phutruonnttn/braille-setup/pcb-audit/video-storyboard-2.jpg

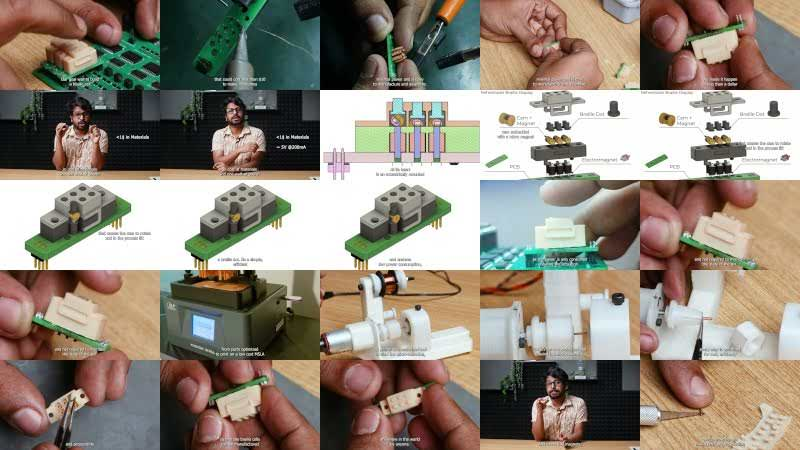
pcb-audit/video-storyboard-2.jpg
