phutruonnttn/braille-setup/pcb-audit/video-storyboard-3.jpg

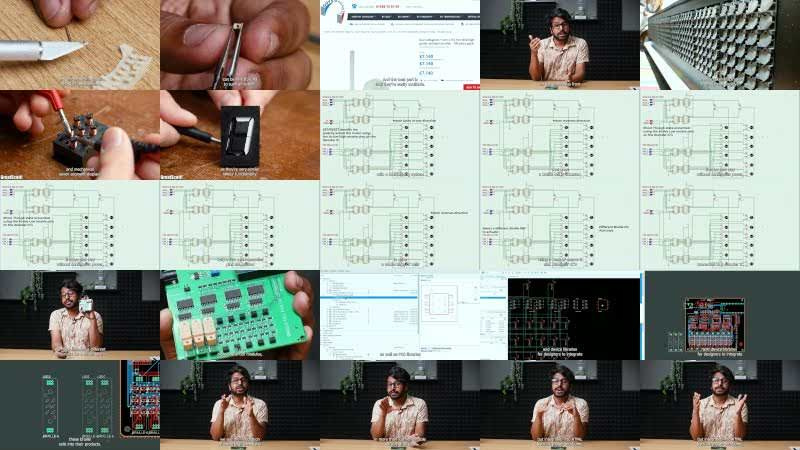
pcb-audit/video-storyboard-3.jpg
