phutruonnttn/braille-setup/pcb-order-4cells-1/verification/cell-drill-report.txt

Drill report for Braille-Cell.kicad_pcb
Created on 2026-10-12T14:58:37

Copper Layer Stackup:
    =============================================================
    L1 :  F.Cu                      front
    L2 :  B.Cu                      back

Drill file 'Braille-Cell-PTH.drl' contains
    plated through holes:
    =============================================================
    T1  0.350mm  0.0138"  (3 holes))
    T2  0.350mm  0.0138"  (12 holes))
    T3  0.600mm  0.0236"  (12 holes))

    Total plated holes count 27

Drill file 'Braille-Cell-NPTH.drl' contains
    unplated through holes:
    =============================================================
    T1  1.100mm  0.0433"  (6 holes))
    T2  1.600mm  0.0630"  (2 holes))
    T3  2.100mm  0.0827"  (2 holes))

    Total unplated holes count 10
