phutruonnttn/braille-setup/guide/overview-preview.png

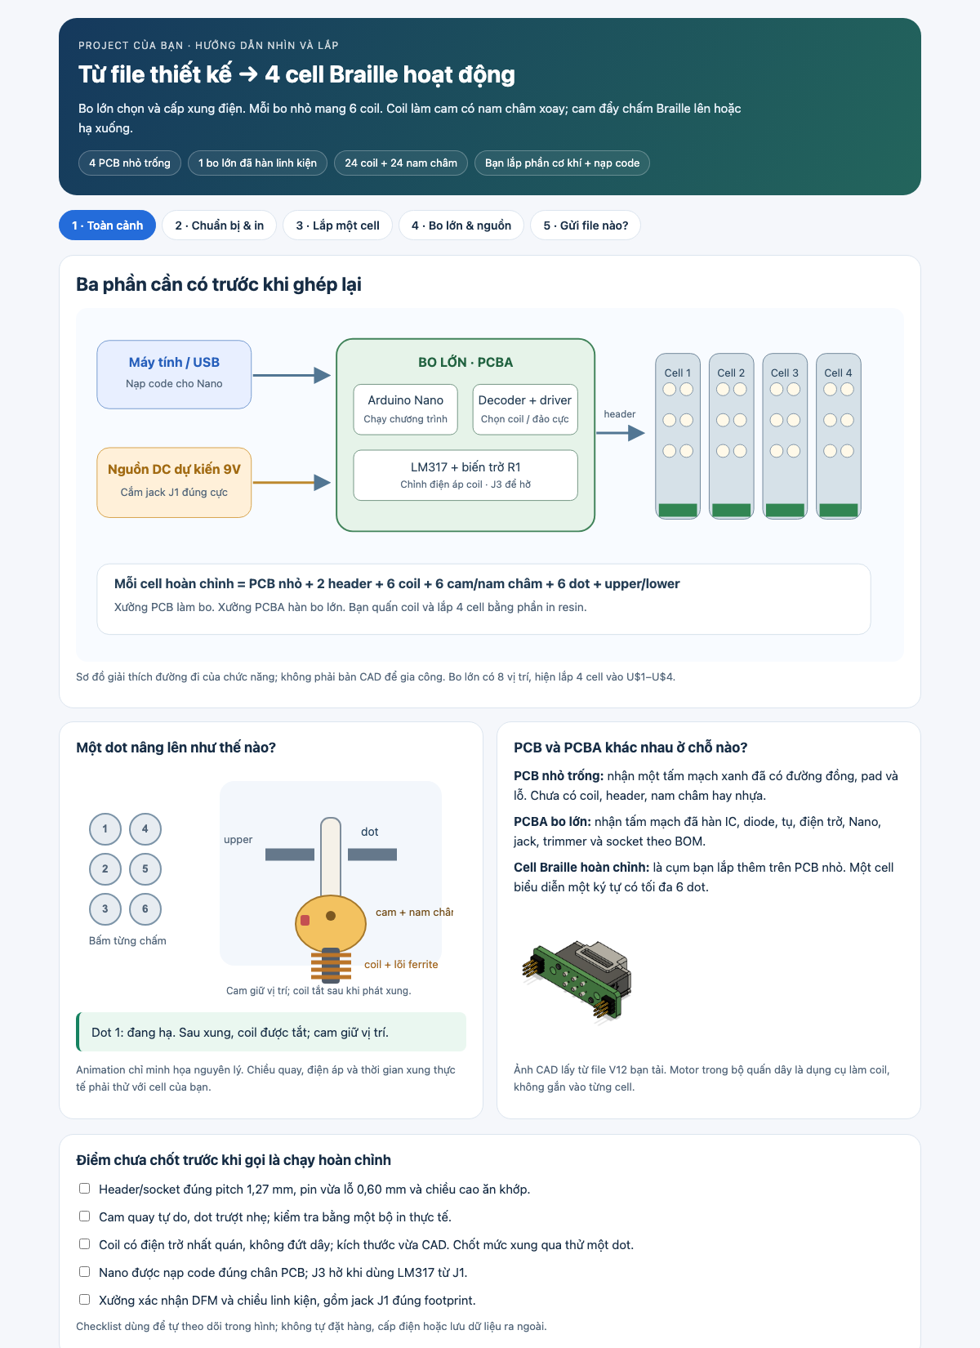
guide/overview-preview.png
