phutruonnttn/braille-setup/pcb-audit/video-storyboard-0.jpg

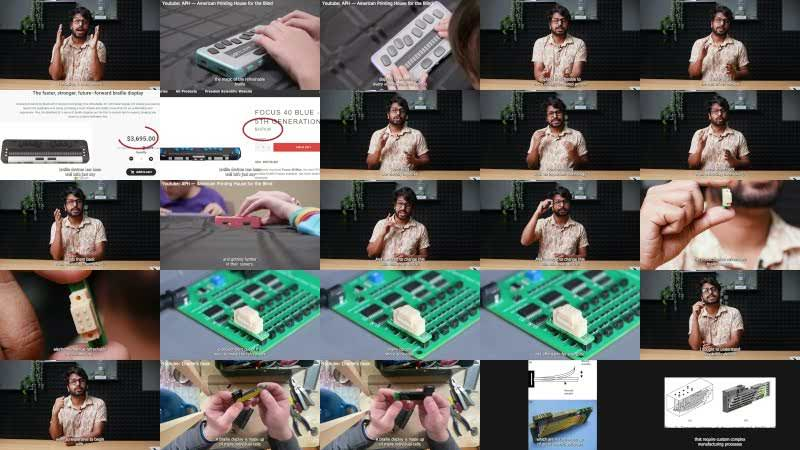
pcb-audit/video-storyboard-0.jpg
