phutruonnttn/braille-setup/pcb-audit/video-storyboard-1.jpg

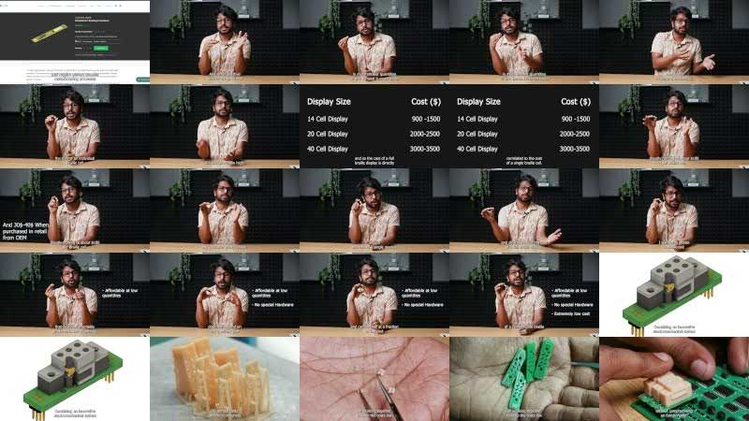
pcb-audit/video-storyboard-1.jpg
