phutruonnttn/braille-setup/pcb-audit/video-storyboard-4.jpg

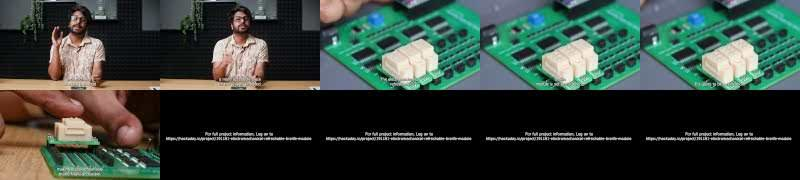
pcb-audit/video-storyboard-4.jpg
