phutruonnttn/braille-setup/pcb-audit/vn-update-2026-10-13/previews/cell-vn-bottom.png

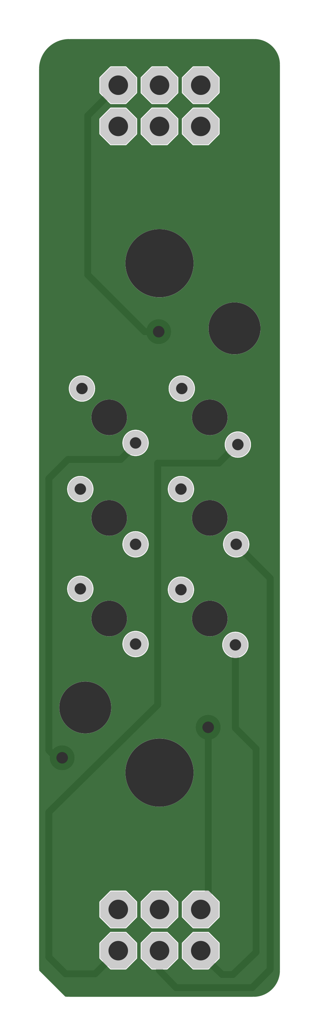
pcb-audit/vn-update-2026-10-13/previews/cell-vn-bottom.png
