phutruonnttn/braille-setup/guide/ferrite-sourcing-Singapore-2026-10-12.md

# Nguồn lõi ferrite cho 4 ô Braille tại Singapore

Kiểm tra ngày 12/10/2026. Giá/tồn kho trên web có thể thay đổi; trợ lý chưa gửi liên hệ hay đặt hàng.

**Cập nhật sau email bạn nhận:** Fair-Rite Asia xác nhận không có hàng để tự lấy tại Singapore; MOQ/SOQ thông thường 6.000 chiếc, đơn nhỏ tùy hàng có sẵn ở Mỹ; vận chuyển Ex-Factory, đề nghị khách tự thu xếp courier. Mục “Ưu tiên 1” dưới đây là phương án hỏi trước khi có phản hồi, hiện đã có kết quả không đáp ứng yêu cầu mua sẵn tại Singapore. Xem [nghiên cứu lõi thay thế và ba đầu mối mới](ferrite-alternatives-2026-10-12.md) cùng [mẫu hỏi mua mẫu](ferrite-alternative-RFQ.txt).

## Cần mua gì

BOM hiện tại cần **24 lõi**, 6 lõi cho mỗi PCB nhỏ. Nên có thêm lõi dự phòng vì dễ gãy khi quấn dây. Mã gốc **Fair-Rite 3067990831**, thanh đặc không phủ, Ø1 ±0,025 mm, dài 10 ±0,30 mm, vật liệu NiZn 67, µi điển hình 40. [Thông số hãng](https://fair-rite.com/product/antennarfid-rods-3067990831/).

## Ưu tiên 1: hỏi chính Fair-Rite tại Singapore

**Fair-Rite Asia Pte Ltd**: 61 Kaki Bukit Ave 1, #03-38 Shun Li Industrial Park; **+65 6846 1998**. Địa chỉ/số điện thoại được hãng công bố trên [trang liên hệ](https://fair-rite.com/contact-us/). Email **sales@fair-rite.com.sg** được [AEIS Singapore](https://www.aeis.org.sg/mem-fair-rite.html) công bố.

Đây là văn phòng hãng, chưa xác nhận có kho bán lẻ. Gọi trước, hỏi hàng mẫu/hàng sẵn, số lượng nhỏ và tự lấy; chỉ đi khi họ xác nhận. Chưa có bằng chứng mua được trong ngày.

Tin nhắn/email có thể gửi:

> Hello, I am based in Singapore and building a personal refreshable Braille prototype. I need 30–50 pieces of Fair-Rite 3067990831, the uncoated material-67 ferrite rod, 1 mm diameter × 10 mm length. Do you have local stock or prototype samples available? Could I self-collect in Singapore or arrange local delivery? Please advise the price, minimum quantity and earliest availability. If this part is unavailable locally, could you recommend a Singapore distributor with stock? Thank you.

## Ưu tiên 2: nhờ bên lắp PCB mua chung

Vì bạn đang nhờ xưởng sourcing linh kiện Evaluation Board, đề nghị họ mua lõi chung đơn linh kiện. Đây là cách có thể giảm phí vận chuyển riêng; phải hỏi xưởng có nhận không.

> Anh báo giúp em thêm 50 lõi Fair-Rite 3067990831, Ø1 × 10 mm, vật liệu 67, không phủ. Em dùng 24 lõi cho 4 ô Braille, phần còn lại dự phòng. Nếu bên anh có đơn DigiKey/Mouser thì anh có thể mua chung và giao lõi rời cho em để em tự quấn cuộn dây được không? Nhờ báo tổng chi phí và thời gian nhận giúp em.

## Ưu tiên 3: đặt trực tiếp DigiKey Singapore

[Trang đúng mã 3067990831](https://www.digikey.sg/en/products/detail/fair-rite-products-corp/3067990831/8599513) hiện hiển thị 6.164 chiếc, mã DigiKey 1934-1516-ND.

| Số lượng | Tiền linh kiện | Ship đơn dưới S$60 | Tổng trước thuế |
|---|---:|---:|---:|
| 25 lõi | S$4,98 | S$24 | S$28,98 |
| 50 lõi | S$8,92 | S$24 | S$32,92 |

Trang ghi giao Singapore thông thường khoảng 3 ngày, miễn phí ship từ S$60. Đây là thời gian thông thường, chưa phải ETA cho địa chỉ của bạn; kiểm tra checkout. Mục “Manufacturer Standard Lead Time” 12 tuần là thời gian bổ sung từ hãng, không nên hiểu là đơn có hàng phải chờ 12 tuần. Với phí ship như trên, 50 lõi đáng cân nhắc hơn 25 vì chỉ chênh S$3,94. Chỉ gộp thêm linh kiện thật sự cần để đạt ngưỡng miễn phí ship.

Làm rõ: [chính sách giao hàng](https://www.digikey.sg/en/help-support/delivery-information/delivery-time-and-cost) nói mốc 3 ngày là thời gian vận chuyển từ trung tâm phân phối ở Mỹ, và thông quan có thể làm chậm. Không phải cam kết nhận hàng trong 3 ngày kể từ lúc đặt; website `.sg` không có nghĩa hàng xuất từ kho Singapore.

## Các đầu mối khác

- **Supreme Components International**: được [Fair-Rite liệt kê trong danh sách distributor](https://fair-rite.com/distributors/), địa chỉ 62 Jalan Eunos, Singapore 419508, **+65 6848 1178**. Chưa xác minh tồn kho, MOQ hay phục vụ mua lẻ; gọi xác nhận địa chỉ trước khi tới.
- **Mouser Singapore**: có listing mã gốc; [chính sách khách hàng mới](https://www.mouser.sg/en/applications/new-customers/) ghi giao thường 3–4 ngày và miễn phí ship phần lớn đơn từ S$60. Chưa xác minh tổng giá/ship nhỏ trên trang SG, nên chưa kết luận rẻ hơn DigiKey. Văn phòng Singapore không chứng minh có kho để tự lấy.
- **IBS Electronics**: [listing](https://www.ibselectronics.com/part/fair-rite/3067990831/822787/) ghi MOQ 500 và ship trong 10 ngày; không phù hợp nhu cầu 24 lõi cần nhanh.

## Taobao / 1688 / Shopee

Đã tìm theo mã và kích thước bằng tiếng Anh/Trung, nhưng **chưa xác minh được listing bán thanh ferrite mềm đặc Ø1 × 10 mm phù hợp**. Trang tìm kiếm trực tiếp Taobao và Shopee cũng không đọc được bằng công cụ hiện có. Không thể kết luận các sàn hoàn toàn không có hàng; cũng chưa có shop nào đủ bằng chứng để khuyên đặt.

Từ khóa để tìm trong app: `3067990831`, `软磁铁氧体磁棒 1×10mm`, `镍锌铁氧体实心圆棒 直径1mm`.

Tin hỏi shop:

> 您好，我需要30–50支未充磁软磁镍锌铁氧体实心圆棒，直径1.00mm，长度10.00mm，用于微型电磁执行器。原型号是Fair-Rite 3067990831，67材料，初始磁导率约40。不是永磁体，不是空心磁珠。请确认是否有现货、尺寸公差、磁材型号或数据表、发货地，以及发到新加坡的时间和总费用。谢谢。

Không chọn chỉ dựa vào chữ “ferrite”: nam châm ferrite vĩnh cửu, hạt chống nhiễu lỗ Ø1 mm, thanh anten Ø10 mm đều khác loại cần mua.

## Có thể thay bằng gì?

| Lựa chọn | Đánh giá cho thiết kế đang in |
|---|---|
| 3067990831 | Ưu tiên giữ đúng thiết kế đã được tác giả dùng |
| [3061990831](https://fair-rite.com/product/antennarfid-rods-3061990831/) | Cùng Ø1 × 10 mm, vật liệu 61, µi 125; ứng viên thử nghiệm, chưa chứng minh hoạt động tương đương |
| [3078990831](https://fair-rite.com/product/antennarfid-rods-3078990831/) | Cùng kích thước, vật liệu MnZn 78, µi 2300; cần thử, không đổi BOM như linh kiện tương đương |
| Thanh ferrite Ø1,2 / 1,5 / 2 mm | Không vừa 6 lỗ lõi Ø1,10 mm của PCB nhỏ hiện tại; cần sửa đồng bộ cơ khí, PCB và cuộn dây |
| Thép kẹp giấy Ø1 mm | Chỉ xem là thử nghiệm tạm; không khuyến nghị cho bộ hoàn chỉnh |

Tác giả [đã thử lõi thép kẹp giấy](https://hackaday.io/project/191181-electromechanical-refreshable-braille-module/log/224226-updated-winding-jig-for-ferrite-cores-vs-steel-cores): có vấn đề nóng cuộn dây và lực hút khiến cam không lật. Khi chuyển ferrite, tác giả ghi nhận chạy mát hơn và thời gian refresh giảm từ 200 xuống 50 ms. Kết quả đó là thử nghiệm của tác giả, không phải thông số bảo đảm cho mọi bộ lắp.

Chưa tìm được vật liệu thay thế vừa dễ mua tại Singapore, vừa có bằng chứng giữ nguyên hiệu năng. Với số lượng nhỏ, hỏi hàng mẫu nội địa hoặc gộp đơn mua mã gốc hợp lý hơn sửa toàn bộ thiết kế. Nếu thử vật liệu khác, làm một cơ cấu trước, kiểm tra cả hai chiều lật, dòng/nhiệt và khả năng lặp lại rồi mới nhân lên 24 cuộn.

## Nhắc lại số lượng PCB

`export/PCB-nho-Gerber.zip` chứa **một thiết kế PCB 7,620 × 29,718 mm**, không phải panel 4 PCB. Gửi một ZIP này và đặt **4 chiếc giống nhau**. PCB lớn là một thiết kế riêng và đặt 1 chiếc.
