phutruonnttn/braille-setup/pcb-order-4cells/Order-Quantities.csv

Item | Quantity | Width mm | Height mm | File
Small cell PCB | 4 | 7.62 | 29.718 | Braille-Cell-Gerbers.zip
Large evaluation PCB | 1 | 98.01225 | 89.6112 | Braille-Evaluation-Gerbers.zip
