phutruonnttn/braille-setup/pcb-order-4cells-1/bom/Evaluation-BOM-Corrected.csv

Qty | Designator | Footprint | Comment | LCSC Part # | Description | Value | Manufacturer | MPN / Specification | Assembly | Notes
5 | C1, C2, C3, C4, C5 | 0603 (1608 metric) | 100nF |  | Ceramic capacitor; 25V minimum; X7R; +/-10% | 100nF |  | 100nF / >=25V / X7R / 0603 | SMT | C5 is 100nF, NOT 9pF. C1-C4 values unchanged.
1 | C6 | 0603 (1608 metric) | 1uF |  | Ceramic capacitor; 25V minimum; X7R; +/-20% | 1uF |  | 1uF / >=25V / X7R / 0603 | SMT | C6 is 1uF, NOT 9pF. Choose adequate effective capacitance under DC bias.
56 | D1, D2, D3, D4, D5, D6, D7, D8, D9, D10, D11, D12, D13, D14, D15, D16, D17, D18, D19, D20, D21, D22, D23, D24, D25, D26, D27, D28, D29, D30, D31, D32, D33, D34, D35, D36, D37, D38, D39, D40, D41, D42, D43, D44, D45, D46, D47, D48, D49, D50, D51, D52, D53, D54, D55, D56 | SOT-23-3 | BAV99 |  | Dual series switching diode; BAV99 pinout | BAV99 |  | BAV99 | SMT | Keep all 56 on the existing 8-cell driver PCB, even with only 4 cells installed.
1 | R3 | 0603 (1608 metric) | 240R |  | Resistor; 240 ohm; +/-1%; >=0.1W | 240R |  | 240R / 1% / 0603 | SMT
4 | IC2, IC3, IC5, IC6 | SOIC-16; 1.27mm pitch; ~6mm overall width | 74HC238D |  | 3-to-8 decoder with active-HIGH outputs | 74HC238D |  | 74HC238D | SMT | Do not substitute 74HC138 (active-LOW). Do not choose TSSOP.
2 | Q1, Q2 | SOP-18; 1.27mm pitch; Toshiba SOP18-P-375-1.27 | TBD62783AFG |  | 8-channel SOURCE DMOS driver | TBD62783AFG | Toshiba | TBD62783AFG,EL | SMT | Use FG package; not FNG/SSOP or PG/DIP. Pin 9=VCC, pin 10=GND.
2 | IC1, IC4 | SO18 / SOP-18; 1.27mm pitch; Toshiba SOP18-P-375-1.27 | TBD62083AFG |  | 8-channel SINK DMOS driver | TBD62083AFG | Toshiba | TBD62083AFG,EL | SMT | Authors build log specifies TBD62083AFG. Eagle symbol was labelled TD62083. Pin 9=GND, pin 10=COMMON; verified against Toshiba datasheet.
1 | U2 | SOT-223 | LM317 |  | Adjustable positive linear regulator; pin 1=ADJ, 2=OUT, 3=IN; tab=OUT | LM317 | Texas Instruments | LM317AEMP/NOPB | SMT | Selected LM317A SOT-223 variant. Pin 1=ADJ, 2=OUT, 3=IN; tab=OUT. Current is limited by thermal dissipation on this PCB; do not buy TO-220 or SOIC variant.
1 | R1 | 3362P | 1k |  | Single-turn through-hole trimmer; 1 kohm | 1k | Bourns | 3362P-1-102LF | THT / hand solder | Footprint: outer pins 5.08mm apart, wiper offset 2.54mm; do not choose 3362W variant.
2 | J2, J3 | 1X02; 2.54mm pitch | 2-pin header |  | Straight 1x2 through-hole header; optional V_DRIVE/GND breakout | 2-pin header |  | 1x2 / 2.54mm pitch | THT / hand solder | J2 was missing from original BOM. Can leave both unpopulated if breakout not needed.
1 | J1 | POWER_JACK_SLOT | DC barrel jack |  | Through-hole barrel jack matching existing 3 round-hole footprint | DC barrel jack |  | Match footprint drawing; 9V supply plug should match jack | THT / hand solder | Do not select by barrel diameter alone. Footprint drawing included; terminal holes are round, 1.0mm.
1 | U$9 | NANO; two 1x15 rows, 2.54mm pitch, 15.24mm row spacing | Arduino Nano |  | Classic 5V ATmega328P Arduino Nano-compatible module | Arduino Nano |  | Classic Arduino Nano 5V / ATmega328P | Module / hand solder | Nano Every / Nano 33 / ESP32 boards are not automatic substitutes.
8 | U$1-U$4: two sockets per cell | 2x3; 1.27mm pitch in both directions | Female socket |  | Female through-hole sockets for 4 active cells, two sockets per cell | Female socket |  | 2x3 / 1.27mm pitch / mating to male cell headers | THT / hand solder | U$5-U$8 remain unpopulated. For all 8 cells, use 16 sockets instead. Confirm mating height.
