phutruonnttn/braille-setup/pcb-audit/vn-update-2026-10-13/bom/Evaluation-BOM-Hand-Assembly.csv

Qty | Designator | Footprint | Comment | LCSC Part # | Description | Value | Manufacturer | MPN / Specification | Assembly | Notes
1 | R1 | 3362P | 1k |  | Single-turn through-hole trimmer; 1 kohm | 1k | Bourns | 3362P-1-102LF | THT / hand solder | Footprint: outer pins 5.08mm apart, wiper offset 2.54mm; do not choose 3362W variant.
1 | J2 | 1X02; 2.54mm pitch | 2-pin header |  | Straight 1x2 header; V_DRIVE/GND measurement breakout | 2-pin header |  | 1x2 / 2.54mm pitch | THT / hand solder | Pin 1=GND; pin 2=V_DRIVE. J2 was missing from original BOM. Do not short these two pins.
1 | J3 | 1X02; 2.54mm pitch | 2-pin header; LEAVE OPEN |  | Optional link between V_DRIVE and Arduino 5V; not a ground breakout | 2-pin header; LEAVE OPEN |  | 1x2 / 2.54mm pitch | THT / hand solder | Pin 1=V_DRIVE; pin 2=Arduino 5V. Do NOT fit a jumper when using external J1 power and the LM317 adjustable supply.
1 | J1 | POWER_JACK_SLOT | DC barrel jack |  | Through-hole barrel jack matching existing 3 round-hole footprint | DC barrel jack |  | Match footprint drawing; 9V supply plug should match jack | THT / hand solder | Do not select by barrel diameter alone. Footprint drawing included; terminal holes are round, 1.0mm.
1 | U$9 | NANO; two 1x15 rows, 2.54mm pitch, 15.24mm row spacing | Arduino Nano |  | Classic 5V ATmega328P Arduino Nano-compatible module | Arduino Nano |  | Classic Arduino Nano 5V / ATmega328P | Module / hand solder | Nano Every / Nano 33 / ESP32 boards are not automatic substitutes.
8 | U$1-U$4: two sockets per cell | 2x3; 1.27mm pitch in both directions | Female socket |  | Female through-hole sockets for 4 active cells, two sockets per cell | Female socket |  | 2x3 / 1.27mm pitch / mating to male cell headers | THT / hand solder | U$5-U$8 remain unpopulated. For all 8 cells, use 16 sockets instead. Confirm mating height.
