phutruonnttn/braille-setup/(list of files, cad)

Other CAD files:
Coil Winding Tool Assembly.f3z
Coil WInding Tool V2.f3z
