phutruonnttn/braille-setup/pcb-audit/vn-update-2026-10-13/gerbers/evaluation/README-MANUFACTURING.txt

BRAILLE EVALUATION / DRIVER BOARD - VN 0.20 MM CHECK

Quantity requested by the current order plan: 1 PCB.
Finished outline centerline: 98.01225 x 89.61120 mm.
2 layers, 1.6 mm FR-4, 1 oz copper.

Copper DRC under the VN 0.20 mm rules has zero error-level violations and zero
missing connections. Remaining warnings are silkscreen/text related plus one
intentional one-layer via warning; they do not change copper connectivity.

Minimum routed track width is 0.3048 mm. Vias use 0.35 mm drills and 0.7564 mm
outer copper, a 0.4064 mm diameter difference. Ordinary same-layer copper
clearance is checked at 0.20 mm; unavoidable fixed IC-pad spacing may use the
factory-approved 0.15 mm exception. Measurements between F.Cu and B.Cu in an
overlaid CAM view are not same-layer copper-clearance violations.

PTH and NPTH drill files are separate. Gerber and drills use the same positive
plot origin. Route on the centerline of Edge_Cuts. Please run factory DFM and
return the CAM preview before production.

For PCBA, use the supplied corrected SMD BOM and regenerated top centroid.
Do not use the original author's BOM/centroid. Verify polarity, pin 1, package,
and rotations against the assembly data before production.
