phutruonnttn/braille-setup/pcb-audit/vn-update-2026-10-13/gerbers/cell/README-MANUFACTURING.txt

SMALL BRAILLE CELL PCB - VN 0.20 MM REVISION

Quantity requested by the current order plan: 4 identical PCBs.
Finished outline centerline: 7.620 x 29.718 mm.
2 layers, 1.6 mm FR-4, 1 oz copper.

Manufacturing constraints checked:
- minimum track width: 0.2032 mm
- minimum ordinary copper clearance: 0.2010 mm
- minimum drill: 0.35 mm
- 0.35 mm via/terminal drill with 0.7564 mm outer copper diameter
- fixed 1.27 mm header-pad local gap: 0.162 mm (approved 0.15 mm exception)

CRITICAL: the TWELVE coil solder terminals must have exposed copper and
solder-mask openings on BOTH sides. Do not tent, plug, or fill those terminals.
The other three routing vias remain tented.

PTH and NPTH drill files are separate. Route on the centerline of Edge_Cuts.
Do not scale or panelize by interpreting the order quantity as artwork.
Please run factory DFM and return the CAM preview before production.
