phutruonnttn/braille-setup/guide/braille-assembly.html

Project của bạn · hướng dẫn nhìn và lắp

# Từ file thiết kế → 4 cell Braille hoạt động

Bo lớn chọn và cấp xung điện. Mỗi bo nhỏ mang 6 coil. Coil làm cam có nam châm xoay; cam đẩy chấm Braille lên hoặc hạ xuống.

4 PCB nhỏ trống1 bo lớn đã hàn linh kiện24 coil + 24 nam châmBạn lắp phần cơ khí + nạp code

## Ba phần cần có trước khi ghép lại

Sơ đồ giải thích đường đi của chức năng; không phải bản CAD để gia công. Bo lớn có 8 vị trí, hiện lắp 4 cell vào U$1–U$4.

### Một dot nâng lên như thế nào?

Bấm từng chấm

Chọn một dot để xem cam đổi vị trí.

Animation chỉ minh họa nguyên lý. Chiều quay, điện áp và thời gian xung thực tế phải thử với cell của bạn.

### PCB và PCBA khác nhau ở chỗ nào?

PCB nhỏ trống: nhận một tấm mạch xanh đã có đường đồng, pad và lỗ. Chưa có coil, header, nam châm hay nhựa.

PCBA bo lớn: nhận tấm mạch đã hàn IC, diode, tụ, điện trở, Nano, jack, trimmer và socket theo BOM.

Cell Braille hoàn chỉnh: là cụm bạn lắp thêm trên PCB nhỏ. Một cell biểu diễn một ký tự có tối đa 6 dot.

Preview nằm trong file Fusion V12 của dự án

Ảnh CAD lấy từ file V12 bạn tải. Motor trong bộ quấn dây là dụng cụ làm coil, không gắn vào từng cell.

## Chuẩn bị cho đúng 4 cell

Phần | Một cell | 4 cell | Để làm gì?
PCB nhỏ | 1 | 4 | Nối 12 đầu dây coil với bo lớn.
Male header 2×3, pitch 1,27 mm | 2 | 8 | Chân cắm nằm ở hai đầu PCB nhỏ.
Lõi ferrite Fair-Rite 3067990831, Ø1 × 10 mm | 6 | 24 | Lõi bên trong coil; không dùng nam châm vĩnh cửu làm lõi.
Coil tự quấn, dây đồng có men Ø0,05 mm | 6 | 24 | Tạo từ trường khi nhận xung điện.
Nam châm N52 Ø1 × 0,5 mm | 6 | 24 | Gắn vào cam để coil làm cam xoay.
Cam in resin | 6 | 24 | Chi tiết xoay đẩy dot.
Dot in resin | 6 | 24 | Chấm Braille trượt lên/xuống.
Upper / lower in resin | 1 / 1 | 4 / 4 | Giữ dot, cam và vị trí coil.
Female socket 2×3, 1,27 mm trên bo lớn | 2 | 8 | Phương án cắm tháo rời; xác nhận chiều cao ăn khớp header.
Bo lớn đã lắp linh kiện + Nano | — | 1 bộ | Chọn cell/coil, cấp xung và đảo cực.

Nếu vẫn có 20 nam châm và 12 lõi như bảng mua ban đầu, bạn còn thiếu 4 nam châm và 12 lõi. Chưa cộng vật tư dự phòng.

### In đúng thứ gì?

Braille Cell V12 (1).f3z

Fusion: mở assembly V12

→

Tách cam / dot / upper / lower

→

STL hoặc 3MF · mm · 100%

→

In resin độ chi tiết cao

- Giữ đúng kích thước; không tự scale toàn cụm để “cho vừa”.
- In thử một bộ, kiểm tra cam xoay và dot trượt rồi mới in đủ 4 bộ.
- Đặt support ở mặt ít quan trọng; tránh dấu support trên trục cam, lỗ nam châm và mặt trượt.
- Cắt support, rửa/cure theo hướng dẫn loại resin; làm sạch phần bám dư.

Tác giả đã thử SLA/DLP và từng phải chỉnh dung sai theo máy/resin. Không có một góc đặt hoặc thời gian cure chung bảo đảm cho mọi máy. Thư mục export hiện chưa có STL riêng từng chi tiết.

### Chuẩn bị dụng cụ gì?

- Mỏ hàn mũi nhỏ, thiếc, flux và kính phóng đại.
- Nhíp chính xác, kìm cắt support, dao nhỏ, giấy nhám để làm sạch ba via nhựa.
- Đồng hồ đo điện, thước cặp; nên có nguồn điều chỉnh và giới hạn dòng để thử coil.
- Keo PVA để cố định cuộn dây, dây đồng men 50 µm và đồ quấn coil.

Coil WInding Tool V2.f3z

Đây là CAD đồ gá quấn coil. In các chi tiết của đồ gá theo assembly; motor, PWM, vòng bi và vít là phần của dụng cụ. Cần kiểm tra motor bạn mua có vừa gá/coupler; không suy ra mọi motor đều thay được cho nhau.

Chưa chốt số vòng, điện trở coil và mức xung cho bản của bạn. Giữ coil giống nhau về hình học và đo điện trở từng coil; không lấy một con số vòng quấn đoán làm thông số chuẩn.

## Lắp từng bước · làm một cell trước

Bấm từng bước để xem các phần đang làm. Hình bung là sơ đồ chức năng, không phải CAD có kích thước.

6 dot / 6 cam / 6 coil · 1 PCB nhỏ. Hình bung đổi hướng để dễ nhìn.

BẠN LÀM

← Bước trướcBước tiếp →

### Hàn một coil vào đâu?

Lỗ lớn ở giữa: chỗ cho lõi ferrite, không phải pad cấp điện.

Hai lỗ nhỏ chéo nhau: hàn hai đầu dây đồng của một coil; pad A ở trên/phải, B ở dưới/trái theo mặt F.Cu.

Chọn quy ước đầu trong/đầu ngoài của cuộn dây và giữ giống nhau ở cả 6 coil. Hai đầu dây không được chạm nhau.

Mặt F.Cu được xác định theo layout/CAD; PCB nhỏ mới không có chữ silk để phân biệt. Đối chiếu ảnh bo ở dưới, không dựa vào “mặt có chữ”.

### Có phải tự đục/khoan PCB không?

Không. Xưởng đã khoan đủ lỗ, mạ những lỗ cần mạ và chừa đồng ở điểm hàn.

Lỗ | Việc của bạn
6 × Ø1,1 mm | Đặt lõi ferrite; không tự mở rộng để “cho nhanh”.
12 × Ø0,35 mm lộ đồng | Luồn/hàn 12 đầu dây coil.
12 × Ø0,60 mm | Hàn hai cụm header.
3 via chuyển lớp Ø0,35 mm | Giữ nguyên, không hàn thêm dây vào.
Lỗ phụ Ø1,6 / Ø2,1 mm | Giữ theo CAD; không cắt hay khoan lại tùy ý.

Phần có thể cần làm sạch là support/ba via nhựa. Nếu lỗ cam quá chật hoặc quá lỏng sau làm sạch, chỉnh dung sai trong CAD và in thử lại. Không mặc định phải khoan cả bộ, và không kẹp/khoan lõi ferrite như thép.

## Bo lớn: xưởng hàn gì, bạn làm gì?

Bấm vùng được đánh số hoặc tên linh kiện để xem chức năng. Nền là ảnh render từ Gerber đã kiểm tra.

### Các chân nguồn cần phân biệt

Chỗ | Chức năng đúng theo netlist
J1 | Jack nguồn ngoài: PWR tới RAW/VIN và đầu vào LM317.
J2 chân 1 / 2 | GND / V_DRIVE. Dùng đo điện áp cấp coil. Không nối tắt hai chân.
J3 chân 1 / 2 | V_DRIVE / 5V Nano. Đây là chỗ chọn nối nguồn, không phải đầu đo GND.

Khi dùng J1 và LM317: J3 để hở, không cắm jumper. Nối J3 sẽ ghép đường điện áp coil điều chỉnh với đường 5V của Nano. BOM đã được sửa lại mô tả J3.

Nguồn adapter 9V là phương án bạn dự kiến; kiểm tra jack và cực nguồn trước cắm. Điện áp coil là V_DRIVE sau LM317, không mặc định bằng 9V.

### Nhận PCBA xong, làm tiếp thế nào?

1. Kiểm tra nguồn/chiều IC và chân hàn với xưởng, chưa cắm cả 4 cell.
2. Nạp firmware cho Nano; khi rảnh phải tắt cả SET và RESET.
3. Đo 5V và V_DRIVE; xác nhận J3 hở. Bắt đầu ở mức V_DRIVE thấp và có giới hạn dòng khi thử.
4. Thử một coil/dot bằng xung ngắn, ngắt dòng sau xung; kiểm tra nhiệt, chiều lên/xuống và lực.
5. Khi một cell chạy ổn đủ 6 dot, lắp lần lượt các cell còn lại vào U$1–U$4.

Chân Nano / firmware còn cần chốt

Net trên PCB | Chân Nano
MOD_0 / MOD_1 / MOD_2 | D6 / D7 / D8
PIN_0 / PIN_1 / PIN_2 | D9 / D10 / D11
SET / RESET | D5 / D4 theo source PCB hiện tại

Tên SET/RESET trong code log tác giả gán ngược so với netlist PCB này. Cần đối chiếu trước khi nạp; hướng lên/xuống còn phụ thuộc cách đấu coil và cực nam châm.

Code 500 ms trong log “Testing Electronics” dùng test LED. Chưa có bộ điện áp/thời gian xung/số vòng đã kiểm chứng cho coil của bạn; không coi đó là firmware coil hoàn chỉnh.

## Gửi file theo đúng người nhận

XƯỞNG PCB

### Muốn nhận 4 PCB nhỏ trống

PCB-nho-Gerber.zip

Gửi 1 thiết kế PCB nhỏ và báo số lượng 4 chiếc. Xưởng dùng các lớp đồng/mask/outline/khoan để làm bo. Chưa hàn header hay coil trong đơn PCB trống này.

XƯỞNG PCBA

### Muốn nhận 1 bo lớn lắp linh kiện

PCB-to-PCBA.zip

Gói đã có Gerber + BOM đầy đủ + BOM SMT/hàn tay + Centroid + hình bo. Yêu cầu sourcing và lắp đủ SMD, Nano, trimmer, jack và socket theo BOM. Hai BOM con là phần tách ra của BOM đầy đủ, không cộng thêm lần nữa.

KHI XƯỞNG XIN PCB GỐCPCB-source-KiCad.zip

Chứa hai file .kicad_pcb và quy tắc thiết kế đi kèm, để xưởng mở KiCad 10 rồi tự xuất CAM. Chỉ gửi khi họ cần và mở được KiCad. Không đổi đuôi thành .brd/.PcbDoc để giả chuyển định dạng.

BÊN IN 3DBraille Cell V12 (1).f3z

CAD assembly cơ khí cho Fusion. Bên có Fusion có thể tách thành STL/3MF; bên chỉ nhận STL cần bạn gửi từng phần cam, dot, upper, lower với số lượng trong bảng. Các ZIP PCB không chứa mô hình in 3D.

Coil WInding Tool V2.f3z

Chỉ dùng nếu cần in đồ gá quấn dây. Không thuộc bốn cell Braille.

Với bên mới làm PCB + PCBA: gửi đúng hai gói PCB-nho-Gerber.zip và PCB-to-PCBA.zip. Số lượng là 4 bo nhỏ + 1 bo lớn, không cần nhân bản file bốn lần.

File phải giữ đuôi .zip. Nếu máy thêm .txt thì bỏ phần .txt trước khi gửi xưởng.

### Mỗi loại file có ý nghĩa gì?

Gerber | Bản vẽ các lớp để sản xuất tấm PCB.
Drill / Excellon | Vị trí và kích thước lỗ; PTH có mạ, NPTH không mạ.
BOM | Danh sách linh kiện để xưởng mua và lắp.
Centroid / Pick & Place | Tọa độ, mặt và góc đặt linh kiện cho máy gắp.
.kicad_pcb / .brd | Thiết kế PCB chỉnh sửa được; KiCad và Eagle là hai định dạng khác nhau.
.f3z / STL / 3MF | CAD cơ khí / dữ liệu hình học để in 3D.

### Nhắn xưởng

Em đang làm project cá nhân, nhờ bên anh báo giá 4 Braille Module PCB trống và 1 Braille Evaluation Board PCBA hoàn chỉnh. Em gửi PCB-nho-Gerber.zip cho bo nhỏ; PCB-to-PCBA.zip cho bo lớn, gồm Gerber, BOM và Centroid. Với bo lớn, nhờ bên anh hỗ trợ sourcing và lắp đủ SMD cùng linh kiện hàn tay theo BOM. Nhờ anh kiểm tra DFM và vị trí/chiều linh kiện trước sản xuất, rồi báo chi phí và thời gian giúp em.

Copy tin nhắn

### Điểm chưa chốt trước khi gọi là chạy hoàn chỉnh

Header/socket đúng pitch 1,27 mm, pin vừa lỗ 0,60 mm và chiều cao ăn khớp. Cam quay tự do, dot trượt nhẹ; kiểm tra bằng một bộ in thực tế. Coil có điện trở nhất quán, không đứt dây; kích thước vừa CAD. Chốt mức xung qua thử một dot. Nano được nạp code đúng chân PCB; J3 hở khi dùng LM317 từ J1. Xưởng xác nhận DFM và chiều linh kiện, gồm jack J1 đúng footprint.

Checklist dùng để tự theo dõi trong hình; không tự đặt hàng, cấp điện hoặc lưu dữ liệu ra ngoài.

Sơ đồ vẽ để học cách lắp, không thay CAD hoặc kiểm nghiệm phần cứng. Nguồn: CAD V12, Eagle/KiCad và BOM của bạn; đối chiếu tài liệu tác giả bên dưới. Bản hướng dẫn không tự tạo STL, firmware hoặc tham số coil đã kiểm nghiệm.

Các bước lắp của tác giả (https://hackaday.io/project/191181/instructions)Dung sai CAD V12 (https://hackaday.io/project/191181/log/224233-12th-time-is-the-charm)Ferrite và quấn coil (https://hackaday.io/project/191181/log/224226-updated-winding-jig-for-ferrite-cores-vs-steel-cores)Test điện tử / code mẫu (https://hackaday.io/project/191181/log/223685-testing-electonics)
