phutruonnttn/braille-setup/guide/pcb-vn-dfm-2026-10-13.html

# Via đã đủ lớn; khe đồng cần đối chiếu lại

Đối chiếu file hiện tại ngày 13/10/2026. Hình minh họa cấu tạo, không phải ảnh chụp PCB.

## 1. Via: lỗ nối hai mặt đồng

Vòng đồng = (đường kính ngoài − lỗ) ÷ 2.

0,7564 − 0,35 = 0,4064 mm → đáp ứng quy tắc xưởng “lớn hơn lỗ ít nhất 0,4 mm”.

Tăng đường kính đồng ngoài sẽ lấn về phía đường mạch bên cạnh, làm khe nhỏ hơn nếu giữ nguyên vị trí.

## 2. Khe đồng: khoảng trống giữa hai net

Chọn mức để hình dung đường mạch cần cách ra bao nhiêu:

Hiện có: 0,1524Xưởng A: 0,20Xưởng B: 0,35

Khe 0,1524 mm nhỏ hơn cả mức 0,20 và 0,35 mm.

Ví dụ dùng bề rộng track bo nhỏ 0,2032 mm. Chỉnh một con số trong phần mềm không tự di chuyển các đường mạch để tạo khe mới.

Kết quả đo hiện tại: track bo nhỏ ≥0,2032 mm; track bo lớn ≥0,3048 mm. Khe track–track nhỏ nhất đo được: bo nhỏ 0,1524 mm, bo lớn 0,2032 mm. Header có khe pad danh nghĩa 0,162 mm.

Cần xác nhận chỗ “0,022 mm” trong ảnh: xin xưởng tên file, lớp đồng và tọa độ lỗi. Phép đo hiện tại chưa xác định được khe track–track khác net cùng lớp nhỏ như vậy; chưa kiểm tra toàn bộ pad và zone theo quy tắc xưởng.

Nguồn: Gerber/Excellon trong PCB-nho-Gerber.zip, PCB-to-PCBA.zip và nguồn KiCad hiện tại. Đây là đối chiếu hình học có giới hạn, chưa phải xác nhận DFM toàn bộ.
