phutruonnttn/braille-setup/guide/assembly-preview.png

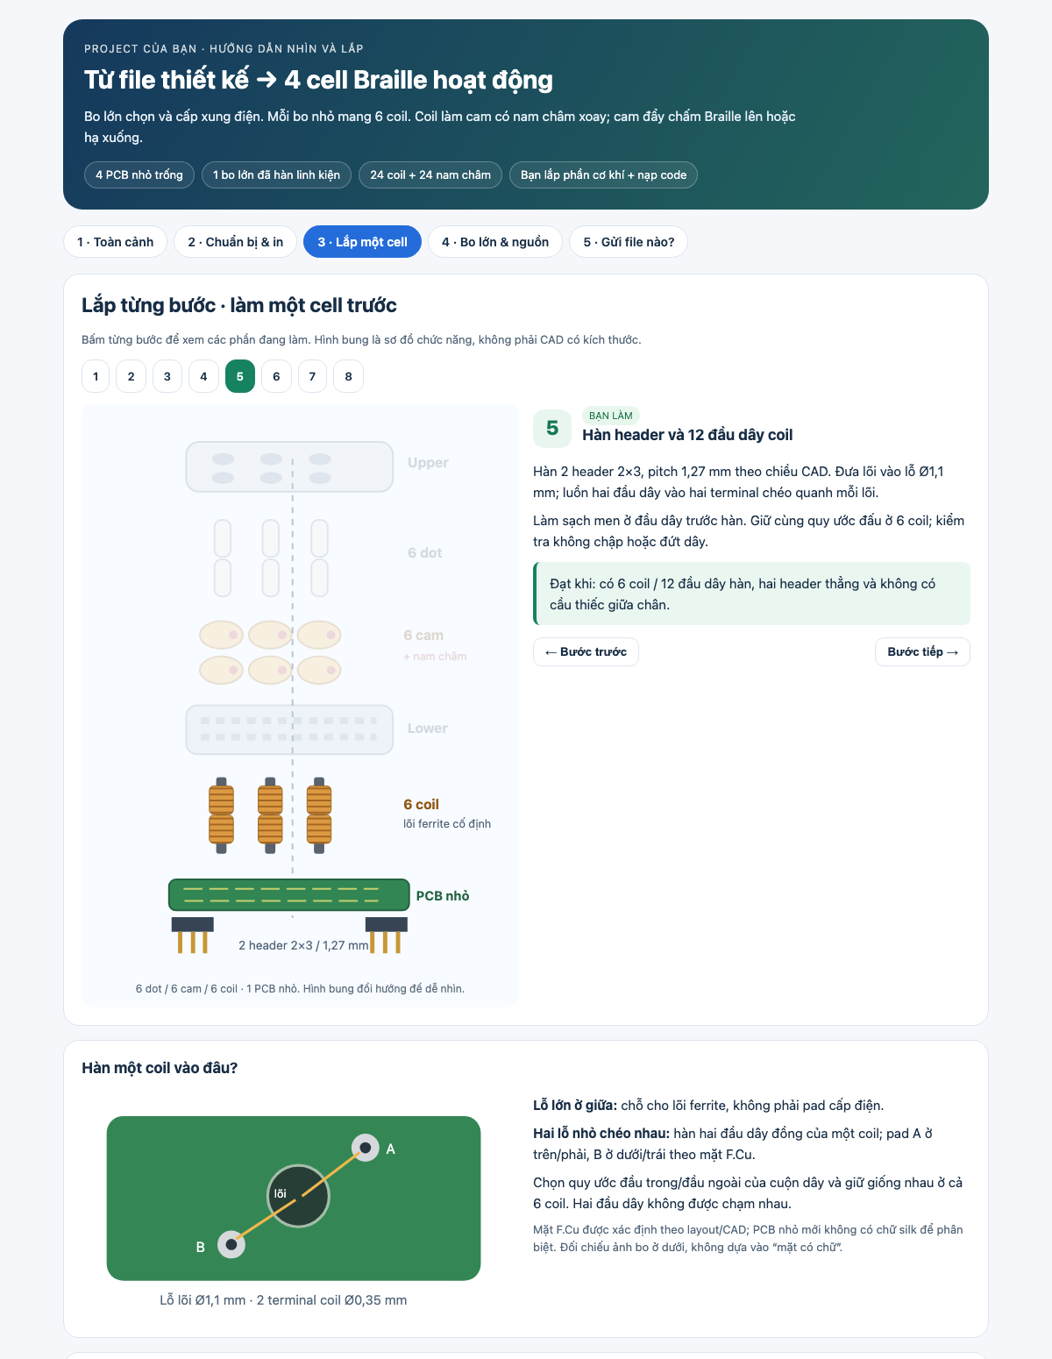
guide/assembly-preview.png
