phutruonnttn/braille-setup/guide/cell-CAD-preview.png

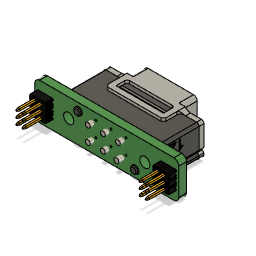
guide/cell-CAD-preview.png
