phutruonnttn/braille-setup/pcb-order-4cells/previews/evaluation-top.png

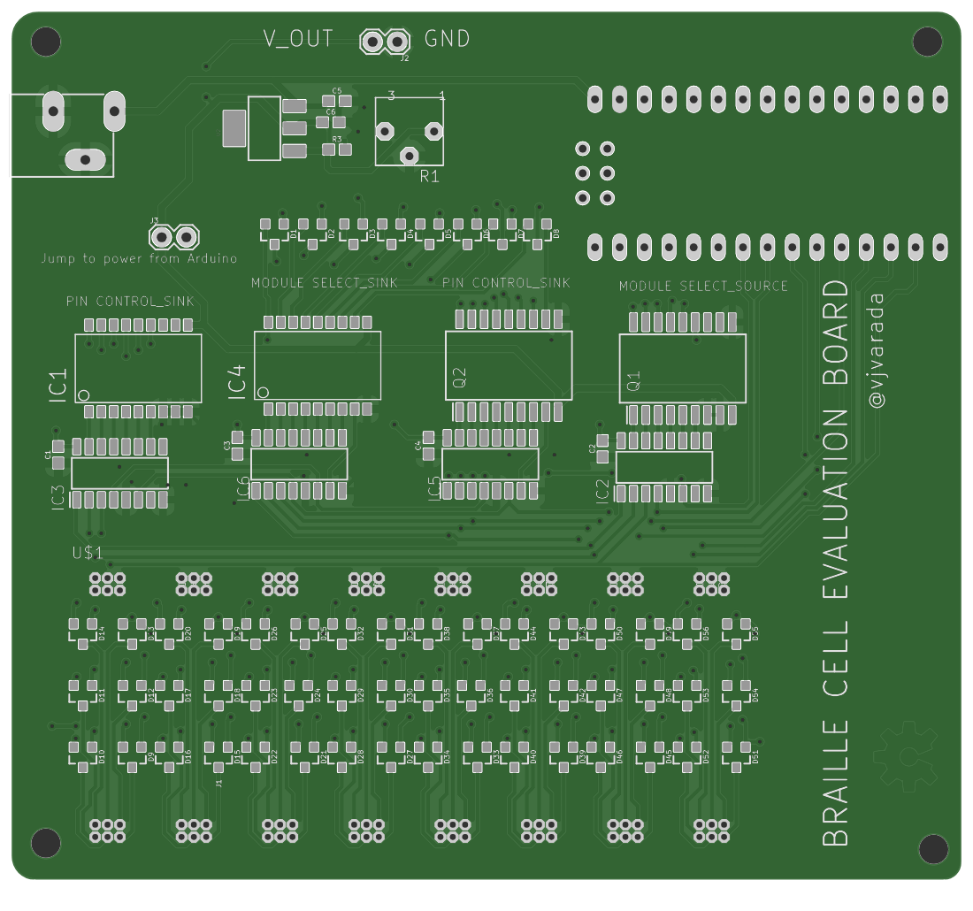
pcb-order-4cells/previews/evaluation-top.png
