phutruonnttn/braille-setup/pcb-audit/vn-update-2026-10-13/source/Braille-Cell.kicad_pcb

## KiCad design pcb-audit/vn-update-2026-10-13/source/Braille-Cell.kicad_pcb (2026-10-13)

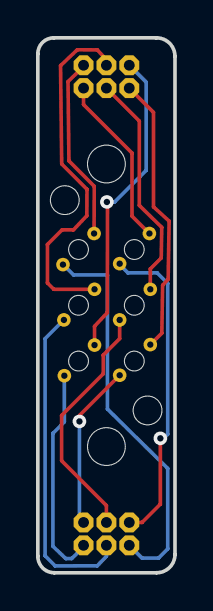
[picture p12: board Braille-Cell.kicad_pcb from above]

Board: 2 copper layers, 7.6 x 29.7 mm, 12 parts (0 on the bottom side), 12 nets.

Parts:
COIL_TERMINALS: 6 coils / 12 exposed PTH solder terminals
U$1: BRAILLE-6
UNK_HOLE_0: dummyfp0
UNK_HOLE_1: dummyfp1
UNK_HOLE_2: dummyfp2
UNK_HOLE_3: dummyfp3
UNK_HOLE_4: dummyfp4
UNK_HOLE_5: dummyfp5
UNK_HOLE_6: dummyfp6
UNK_HOLE_7: dummyfp7
UNK_HOLE_8: dummyfp8
UNK_HOLE_9: dummyfp9

Connections:
1A: COIL_TERMINALS.1A, U$1.P$1
1B: COIL_TERMINALS.1B, U$1.P$2
2A: COIL_TERMINALS.2A, U$1.P$3
2B: COIL_TERMINALS.2B, U$1.P$4
3A: COIL_TERMINALS.3A, U$1.P$5
3B: COIL_TERMINALS.3B, U$1.P$6
4A: COIL_TERMINALS.4A, U$1.P$7
4B: COIL_TERMINALS.4B, U$1.P$8
5A: COIL_TERMINALS.5A, U$1.P$9
5B: COIL_TERMINALS.5B, U$1.P$10
6A: COIL_TERMINALS.6A, U$1.P$11
6B: COIL_TERMINALS.6B, U$1.P$12
