phutruonnttn/braille-setup/export/PCB-source-KiCad/Braille-Evaluation.kicad_pcb

## KiCad design export/PCB-source-KiCad/Braille-Evaluation.kicad_pcb (2026-10-13)

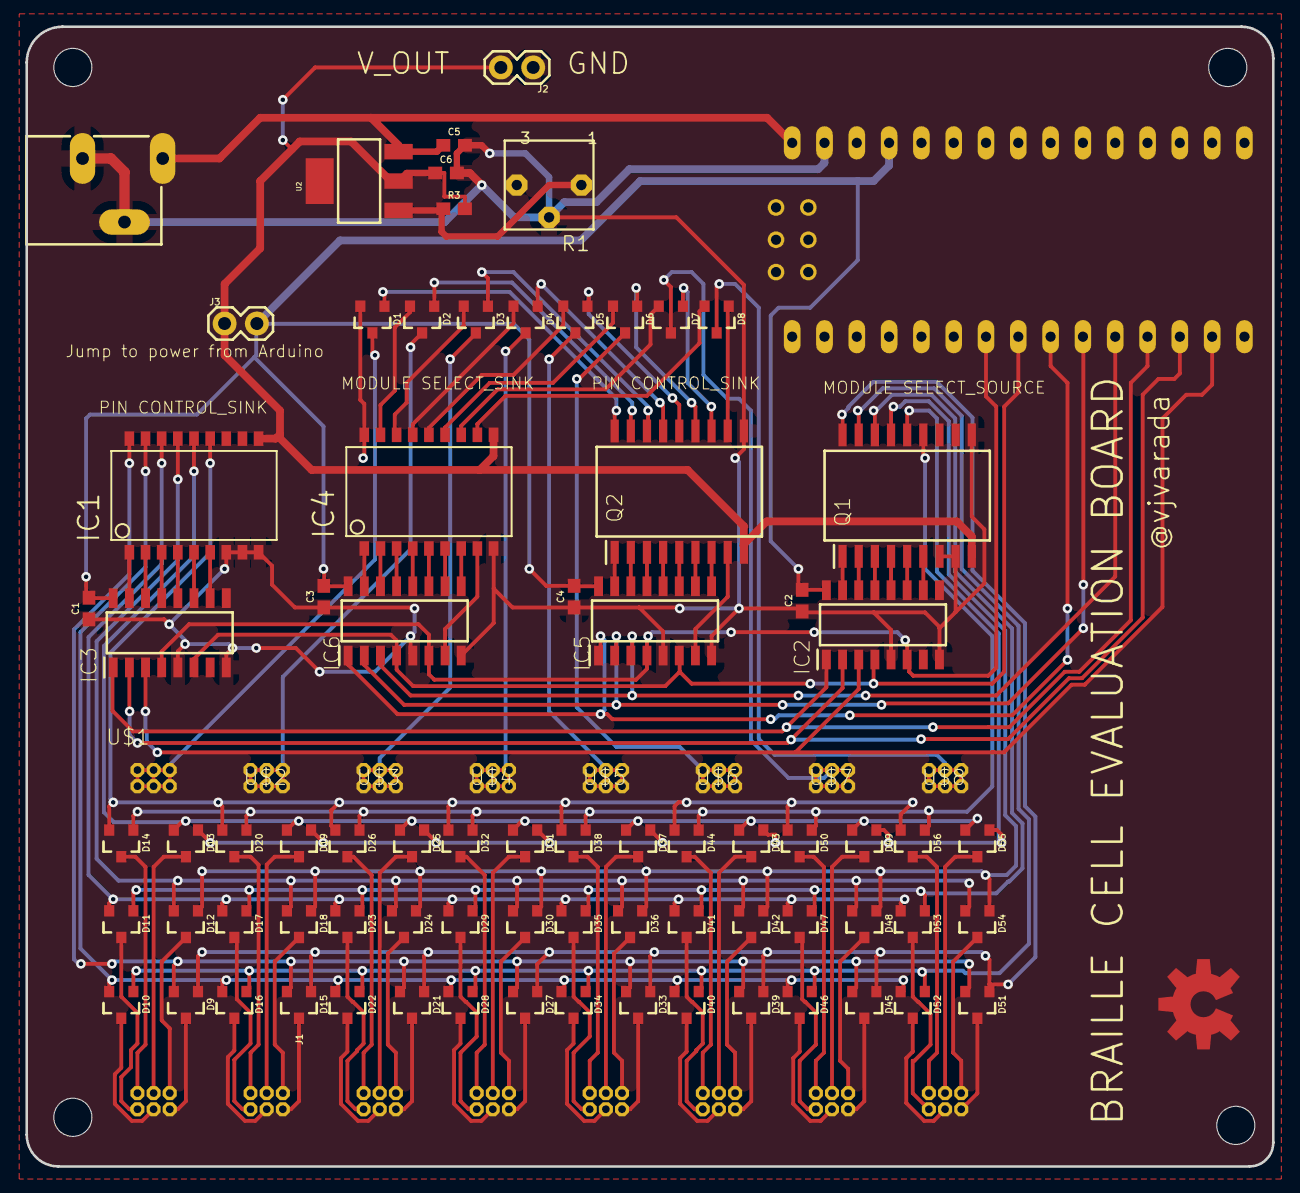
[picture p13: board Braille-Evaluation.kicad_pcb from above]

Board: 2 copper layers, 98.0 x 89.6 mm, 90 parts (0 on the bottom side), 125 nets.

Parts:
C1, C2, C3, C4, C5: 0.1uF; 0603
C6: 1uf; 0603
D1, D2, D3, D4, D5, D6, D7, D8, D9, D10, D11, D12, D13, D14, D15, D16, D17, D18, D19, D20, D21, D22, D23, D24, D25, D26, D27, D28, D29, D30, D31, D32, D33, D34, D35, D36, D37, D38, D39, D40, D41, D42, D43, D44, D45, D46, D47, D48, D49, D50, D51, D52, D53, D54, D55, D56: 200mA/70V; SOT23-3
IC1, IC4: TBD62083AFG; SO18
IC2, IC3, IC5, IC6: 74HC238D; SOIC127P600X175-16N
J1: POWER_JACKSLT; POWER_JACK_SLOT
J2, J3: 1X02
LOGO1: OSHW-LOGOL-COPPER; OSHW-LOGO-L_COPPER
Q1, Q2: TBD62783AFG,EL; SOIC127P1030X245-18N
R1: 1k; 3362P
R3: 240R; 0603
U2: LM317; SOT223
U$1, U$2, U$3, U$4, U$5, U$6, U$7, U$8: BRAILLE-6
U$9: NANO
UNK_HOLE_0: dummyfp0
UNK_HOLE_1: dummyfp1
UNK_HOLE_2: dummyfp2
UNK_HOLE_3: dummyfp3

Connections:
GND: C1.1, C2.1, C3.1, C4.1, C5.2, C6.2, IC1.7, IC1.8, IC1.9, IC2.5, IC2.8, IC3.5, IC3.8, IC4.9, IC5.5, IC5.8, IC6.5, IC6.8, J1.GND@1, J1.GND@2, J2.1, Q1.7, Q1.8, Q1.10, Q2.10, R1.2, U$9.GND
MOD_0: IC5.1, IC6.1, U$9.D6
MOD_1: IC5.2, IC6.2, U$9.D7
MOD_2: IC5.3, IC6.3, U$9.D8
unnamed: IC2.15, Q1.1
unnamed: IC2.14, Q1.2
unnamed: IC2.13, Q1.3
unnamed: IC2.12, Q1.4
unnamed: IC2.11, Q1.5
unnamed: IC2.10, Q1.6
unnamed: IC1.1, IC3.15
unnamed: IC1.2, IC3.14
unnamed: IC1.3, IC3.13
unnamed: IC1.4, IC3.12
unnamed: IC1.5, IC3.11
unnamed: IC5.15, Q2.1
unnamed: IC5.14, Q2.2
unnamed: IC5.13, Q2.3
unnamed: IC5.12, Q2.4
unnamed: IC5.11, Q2.5
unnamed: D1.1, Q2.18
unnamed: IC4.1, IC6.15
unnamed: IC4.2, IC6.14
unnamed: IC4.3, IC6.13
unnamed: IC4.4, IC6.12
unnamed: IC4.5, IC6.11
unnamed: D2.1, Q2.17
unnamed: IC5.10, Q2.6
unnamed: D3.1, Q2.16
unnamed: IC5.9, Q2.7
unnamed: IC5.7, Q2.8
unnamed: IC4.8, IC6.7
unnamed: IC4.6, IC6.10
unnamed: IC4.7, IC6.9
unnamed: D4.1, Q2.15
unnamed: IC1.6, IC3.10
unnamed: D5.1, Q2.14
unnamed: D6.1, Q2.13
unnamed: D7.1, Q2.12
unnamed: D8.1, Q2.11
unnamed: D1.2, IC4.18
unnamed: D9.3, U$1.P$2
unnamed: D2.2, IC4.17
unnamed: D3.3, U$3.P$1, U$3.P$3, U$3.P$5, U$3.P$7, U$3.P$9, U$3.P$11
unnamed: D4.3, U$4.P$1, U$4.P$3, U$4.P$5, U$4.P$7, U$4.P$9, U$4.P$11
unnamed: D5.3, U$5.P$1, U$5.P$3, U$5.P$5, U$5.P$7, U$5.P$9, U$5.P$11
unnamed: D6.3, U$6.P$1, U$6.P$3, U$6.P$5, U$6.P$7, U$6.P$9, U$6.P$11
unnamed: D7.3, U$7.P$1, U$7.P$3, U$7.P$5, U$7.P$7, U$7.P$9, U$7.P$11
unnamed: D8.3, U$8.P$1, U$8.P$3, U$8.P$5, U$8.P$7, U$8.P$9, U$8.P$11
unnamed: D10.3, U$1.P$4
unnamed: D11.3, U$1.P$6
unnamed: D12.3, U$1.P$8
unnamed: D13.3, U$1.P$10
unnamed: D14.3, U$1.P$12
unnamed: D21.3, U$3.P$2
unnamed: D10.1, D16.1, D22.1, D28.1, D34.1, D40.1, D46.1, D52.1, Q1.17
unnamed: D11.1, D17.1, D23.1, D29.1, D35.1, D41.1, D47.1, D53.1, Q1.16
unnamed: D12.1, D18.1, D24.1, D30.1, D36.1, D42.1, D48.1, D54.1, Q1.15
unnamed: D27.3, U$4.P$2
unnamed: D33.3, U$5.P$2
unnamed: D9.2, D15.2, D21.2, D27.2, D33.2, D39.2, D45.2, D51.2, IC1.18
unnamed: D39.3, U$6.P$2
unnamed: D11.2, D17.2, D23.2, D29.2, D35.2, D41.2, D47.2, D53.2, IC1.16
unnamed: D12.2, D18.2, D24.2, D30.2, D36.2, D42.2, D48.2, D54.2, IC1.15
unnamed: D13.2, D19.2, D25.2, D31.2, D37.2, D43.2, D49.2, D55.2, IC1.14
unnamed: D14.2, D20.2, D26.2, D32.2, D38.2, D44.2, D50.2, D56.2, IC1.13
unnamed: D15.3, U$2.P$2
unnamed: D16.3, U$2.P$4
unnamed: D17.3, U$2.P$6
unnamed: D18.3, U$2.P$8
unnamed: D19.3, U$2.P$10
unnamed: D20.3, U$2.P$12
unnamed: D28.3, U$4.P$4
unnamed: D22.3, U$3.P$4
unnamed: D23.3, U$3.P$6
unnamed: D24.3, U$3.P$8
unnamed: D25.3, U$3.P$10
unnamed: D26.3, U$3.P$12
unnamed: D45.3, U$7.P$2
unnamed: D10.2, D16.2, D22.2, D28.2, D34.2, D40.2, D46.2, D52.2, IC1.17
unnamed: D51.3, U$8.P$2
unnamed: D1.3, U$1.P$1, U$1.P$3, U$1.P$5, U$1.P$7, U$1.P$9, U$1.P$11
unnamed: D2.3, U$2.P$1, U$2.P$3, U$2.P$5, U$2.P$7, U$2.P$9, U$2.P$11
unnamed: D29.3, U$4.P$6
unnamed: D30.3, U$4.P$8
unnamed: D3.2, IC4.16
unnamed: D13.1, D19.1, D25.1, D31.1, D37.1, D43.1, D49.1, D55.1, Q1.14
unnamed: D14.1, D20.1, D26.1, D32.1, D38.1, D44.1, D50.1, D56.1, Q1.13
unnamed: D4.2, IC4.15
unnamed: D5.2, IC4.14
unnamed: D6.2, IC4.13
unnamed: D7.2, IC4.12
unnamed: D8.2, IC4.11
unnamed: D31.3, U$4.P$10
unnamed: D32.3, U$4.P$12
unnamed: R1.1, R3.1, U2.1
unnamed: D34.3, U$5.P$4
unnamed: D35.3, U$5.P$6
unnamed: D36.3, U$5.P$8
unnamed: D37.3, U$5.P$10
unnamed: D38.3, U$5.P$12
unnamed: D40.3, U$6.P$4
unnamed: D41.3, U$6.P$6
unnamed: D42.3, U$6.P$8
unnamed: D43.3, U$6.P$10
unnamed: D44.3, U$6.P$12
unnamed: D46.3, U$7.P$4
unnamed: D47.3, U$7.P$6
unnamed: D48.3, U$7.P$8
unnamed: D49.3, U$7.P$10
unnamed: D50.3, U$7.P$12
unnamed: D52.3, U$8.P$4
unnamed: D53.3, U$8.P$6
unnamed: D54.3, U$8.P$8
unnamed: D55.3, U$8.P$10
unnamed: D56.3, U$8.P$12
unnamed: D9.1, D15.1, D21.1, D27.1, D33.1, D39.1, D45.1, D51.1, Q1.18
PIN_0: IC2.1, IC3.1, U$9.D9
PIN_1: IC2.2, IC3.2, U$9.D10
PIN_2: IC2.3, IC3.3, U$9.D11
RAW: C5.1, J1.PWR, U2.3, U$9.RAW
RESET: IC2.6, IC3.4, IC5.4, IC6.6, U$9.D4
SET: IC2.4, IC3.6, IC5.6, IC6.4, U$9.D5
VCC: C1.2, C2.2, C3.2, C4.2, IC2.16, IC3.16, IC5.16, IC6.16, J3.2, U$9.5V
V_DRIVE: C6.1, IC1.10, IC4.10, J2.2, J3.1, Q1.9, Q2.9, R3.2, U2.2
