phutruonnttn/braille-setup/pcb-audit/extracted/Braille Evaluation Board Eagle Source Files/Braille Evaluation Board Eagle Source Files/Braille Evaluation Board.brd

## EAGLE design pcb-audit/extracted/Braille Evaluation Board Eagle Source Files/Braille Evaluation Board Eagle Source Files/Braille Evaluation Board.brd (2026-10-13)

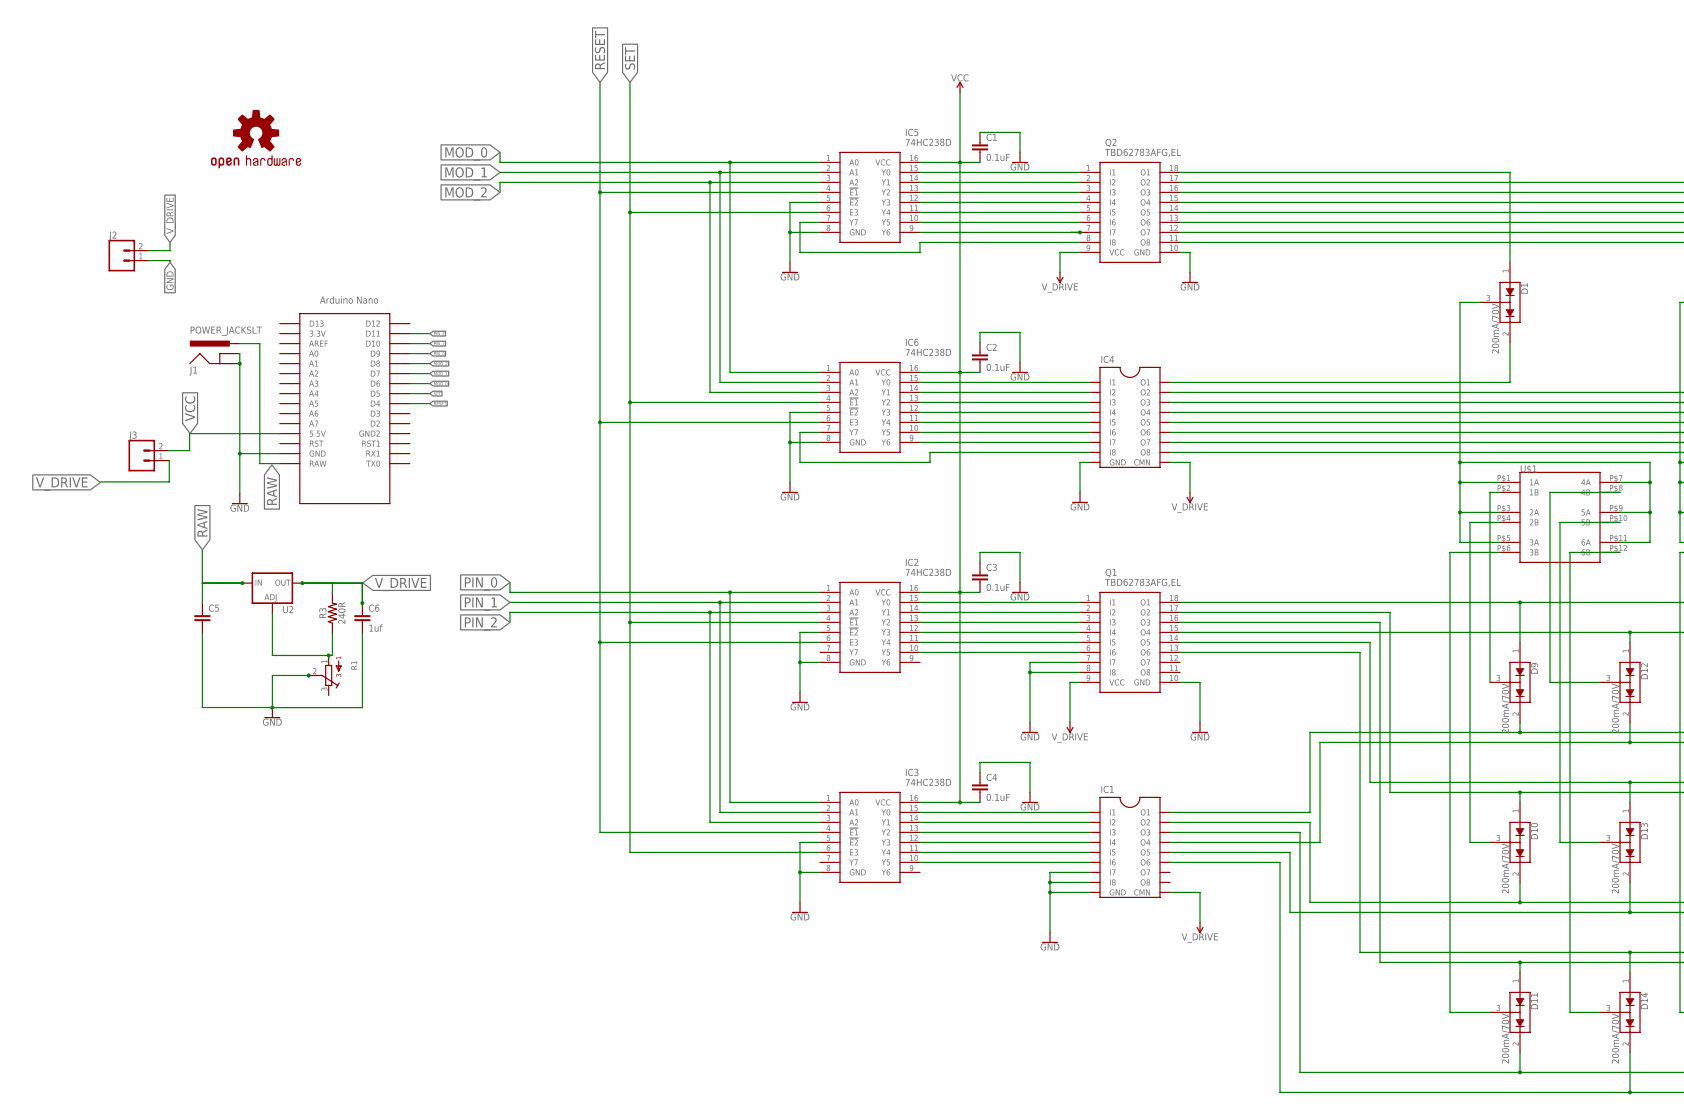
[picture p14: schematic Braille Evaluation Board.sch, part in row 1, column 1]

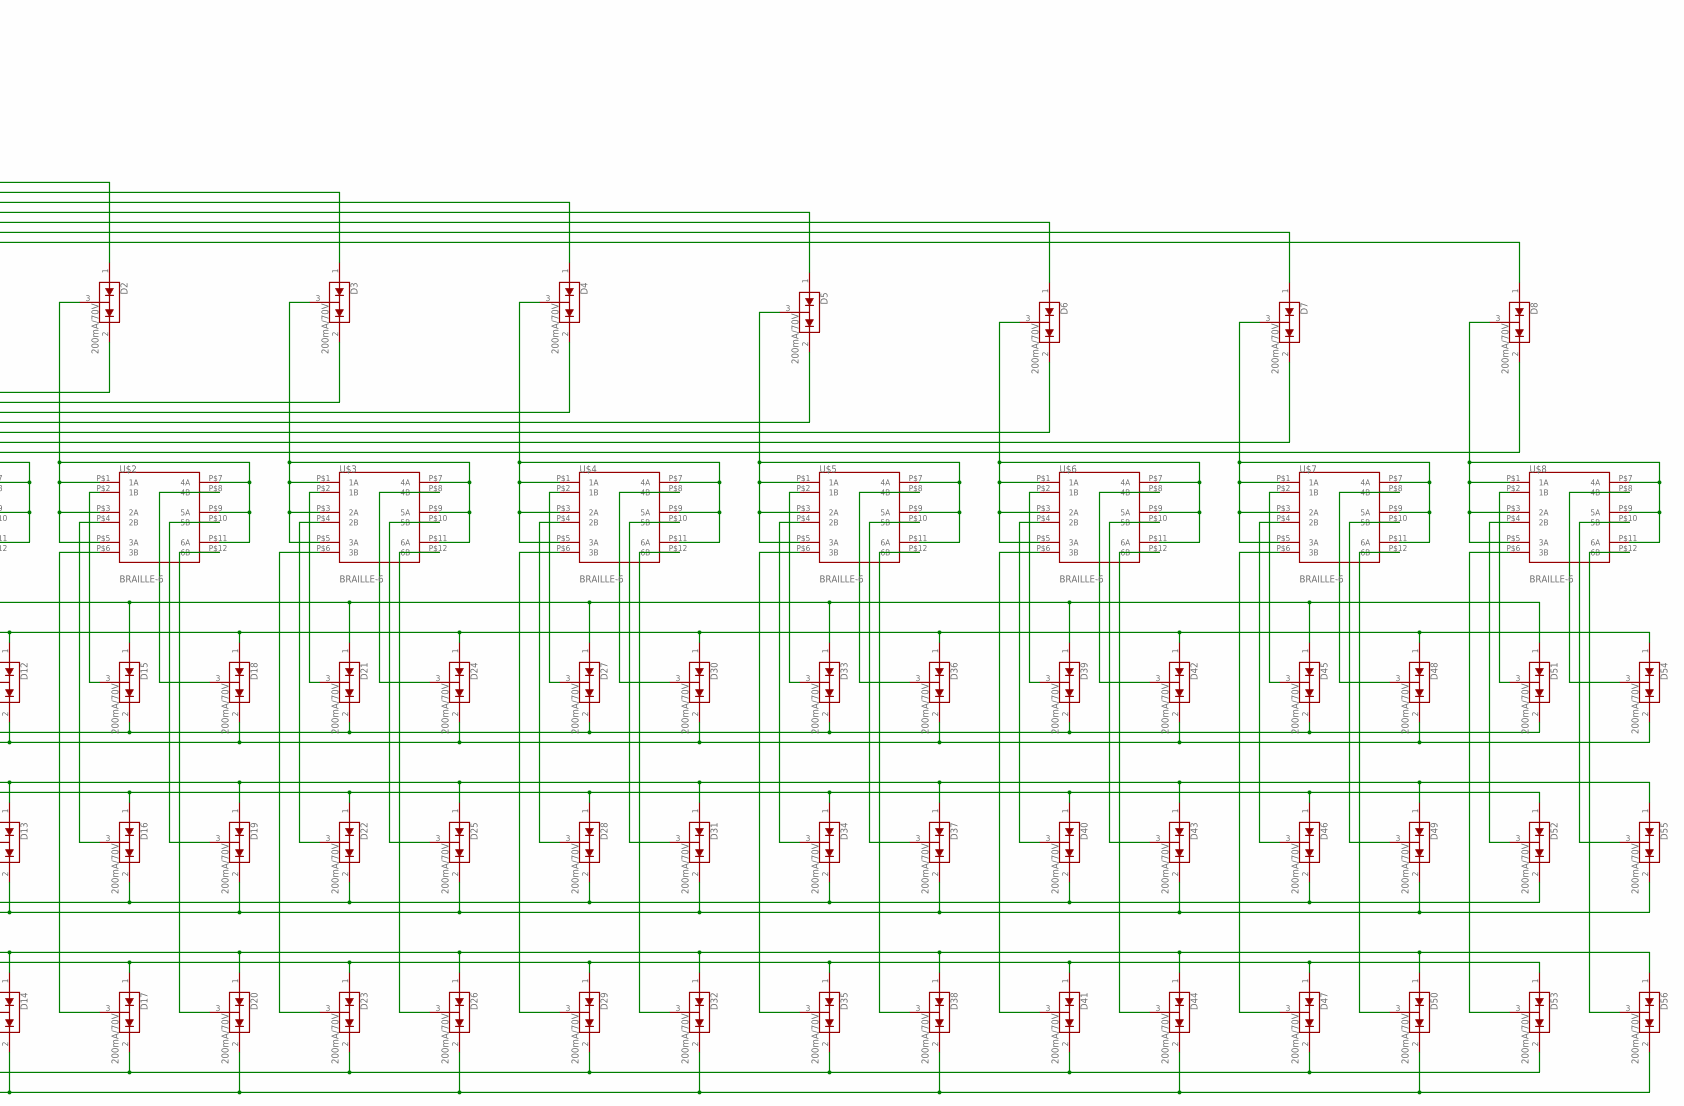
[picture p15: schematic Braille Evaluation Board.sch, part in row 1, column 2]

Parts:
C1, C2, C3, C4, C5: 0.1uF; 0603
C6: 1uf; 0603
D1, D2, D3, D4, D5, D6, D7, D8, D9, D10, D11, D12, D13, D14, D15, D16, D17, D18, D19, D20, D21, D22, D23, D24, D25, D26, D27, D28, D29, D30, D31, D32, D33, D34, D35, D36, D37, D38, D39, D40, D41, D42, D43, D44, D45, D46, D47, D48, D49, D50, D51, D52, D53, D54, D55, D56: 200mA/70V; SOT23-3
IC1, IC4: TD62083; SO18
IC2, IC3, IC5, IC6: 74HC238D; SOIC127P600X175-16N
J1: POWER_JACKSLT; POWER_JACK_SLOT
J2, J3: CONN_02; 1X02
LOGO1: OSHW-LOGOL-COPPER; OSHW-LOGO-L_COPPER
Q1, Q2: TBD62783AFG,EL; SOIC127P1030X245-18N
R1: 3362P
R3: 240R; 0603
U2: LM317; SOT223
U$1, U$2, U$3, U$4, U$5, U$6, U$7, U$8: BRAILLE-6
U$9: NANO

Connections:
GND: C1.1, C2.1, C3.1, C4.1, C5.2, C6.2, IC1.7 (I7), IC1.8 (I8), IC1.9 (GND), IC2.5 (!E2), IC2.8 (GND), IC3.5 (!E2), IC3.8 (GND), IC4.9 (GND), IC5.5 (!E2), IC5.8 (GND), IC6.5 (!E2), IC6.8 (GND), J1.GND@1 (GNDBREAK), J1.GND@2 (GND), J2.1, Q1.7 (I7), Q1.8 (I8), Q1.10 (GND), Q2.10 (GND), R1.2, U$9.GND
MOD_0: IC5.1 (A0), IC6.1 (A0), U$9.D6
MOD_1: IC5.2 (A1), IC6.2 (A1), U$9.D7
MOD_2: IC5.3 (A2), IC6.3 (A2), U$9.D8
unnamed: IC2.15 (Y0), Q1.1 (I1)
unnamed: IC2.14 (Y1), Q1.2 (I2)
unnamed: IC2.13 (Y2), Q1.3 (I3)
unnamed: IC2.12 (Y3), Q1.4 (I4)
unnamed: IC2.11 (Y4), Q1.5 (I5)
unnamed: IC2.10 (Y5), Q1.6 (I6)
unnamed: IC1.1 (I1), IC3.15 (Y0)
unnamed: IC1.2 (I2), IC3.14 (Y1)
unnamed: IC1.3 (I3), IC3.13 (Y2)
unnamed: IC1.4 (I4), IC3.12 (Y3)
unnamed: IC1.5 (I5), IC3.11 (Y4)
unnamed: IC5.15 (Y0), Q2.1 (I1)
unnamed: IC5.14 (Y1), Q2.2 (I2)
unnamed: IC5.13 (Y2), Q2.3 (I3)
unnamed: IC5.12 (Y3), Q2.4 (I4)
unnamed: IC5.11 (Y4), Q2.5 (I5)
unnamed: D1.1 (A1), Q2.18 (O1)
unnamed: IC4.1 (I1), IC6.15 (Y0)
unnamed: IC4.2 (I2), IC6.14 (Y1)
unnamed: IC4.3 (I3), IC6.13 (Y2)
unnamed: IC4.4 (I4), IC6.12 (Y3)
unnamed: IC4.5 (I5), IC6.11 (Y4)
unnamed: D2.1 (A1), Q2.17 (O2)
unnamed: IC5.10 (Y5), Q2.6 (I6)
unnamed: D3.1 (A1), Q2.16 (O3)
unnamed: IC5.9 (Y6), Q2.7 (I7)
unnamed: IC5.7 (Y7), Q2.8 (I8)
unnamed: IC4.8 (I8), IC6.7 (Y7)
unnamed: IC4.6 (I6), IC6.10 (Y5)
unnamed: IC4.7 (I7), IC6.9 (Y6)
unnamed: D4.1 (A1), Q2.15 (O4)
unnamed: IC1.6 (I6), IC3.10 (Y5)
unnamed: D5.1 (A1), Q2.14 (O5)
unnamed: D6.1 (A1), Q2.13 (O6)
unnamed: D7.1 (A1), Q2.12 (O7)
unnamed: D8.1 (A1), Q2.11 (O8)
unnamed: D1.2 (C2), IC4.18 (O1)
unnamed: D9.3 (COM), U$1.P$2 (1B)
unnamed: D2.2 (C2), IC4.17 (O2)
unnamed: D3.3 (COM), U$3.P$1 (1A), U$3.P$3 (2A), U$3.P$5 (3A), U$3.P$7 (4A), U$3.P$9 (5A), U$3.P$11 (6A)
unnamed: D4.3 (COM), U$4.P$1 (1A), U$4.P$3 (2A), U$4.P$5 (3A), U$4.P$7 (4A), U$4.P$9 (5A), U$4.P$11 (6A)
unnamed: D5.3 (COM), U$5.P$1 (1A), U$5.P$3 (2A), U$5.P$5 (3A), U$5.P$7 (4A), U$5.P$9 (5A), U$5.P$11 (6A)
unnamed: D6.3 (COM), U$6.P$1 (1A), U$6.P$3 (2A), U$6.P$5 (3A), U$6.P$7 (4A), U$6.P$9 (5A), U$6.P$11 (6A)
unnamed: D7.3 (COM), U$7.P$1 (1A), U$7.P$3 (2A), U$7.P$5 (3A), U$7.P$7 (4A), U$7.P$9 (5A), U$7.P$11 (6A)
unnamed: D8.3 (COM), U$8.P$1 (1A), U$8.P$3 (2A), U$8.P$5 (3A), U$8.P$7 (4A), U$8.P$9 (5A), U$8.P$11 (6A)
unnamed: D10.3 (COM), U$1.P$4 (2B)
unnamed: D11.3 (COM), U$1.P$6 (3B)
unnamed: D12.3 (COM), U$1.P$8 (4B)
unnamed: D13.3 (COM), U$1.P$10 (5B)
unnamed: D14.3 (COM), U$1.P$12 (6B)
unnamed: D21.3 (COM), U$3.P$2 (1B)
unnamed: D10.1 (A1), D16.1 (A1), D22.1 (A1), D28.1 (A1), D34.1 (A1), D40.1 (A1), D46.1 (A1), D52.1 (A1), Q1.17 (O2)
unnamed: D11.1 (A1), D17.1 (A1), D23.1 (A1), D29.1 (A1), D35.1 (A1), D41.1 (A1), D47.1 (A1), D53.1 (A1), Q1.16 (O3)
unnamed: D12.1 (A1), D18.1 (A1), D24.1 (A1), D30.1 (A1), D36.1 (A1), D42.1 (A1), D48.1 (A1), D54.1 (A1), Q1.15 (O4)
unnamed: D27.3 (COM), U$4.P$2 (1B)
unnamed: D33.3 (COM), U$5.P$2 (1B)
unnamed: D9.2 (C2), D15.2 (C2), D21.2 (C2), D27.2 (C2), D33.2 (C2), D39.2 (C2), D45.2 (C2), D51.2 (C2), IC1.18 (O1)
unnamed: D39.3 (COM), U$6.P$2 (1B)
unnamed: D11.2 (C2), D17.2 (C2), D23.2 (C2), D29.2 (C2), D35.2 (C2), D41.2 (C2), D47.2 (C2), D53.2 (C2), IC1.16 (O3)
unnamed: D12.2 (C2), D18.2 (C2), D24.2 (C2), D30.2 (C2), D36.2 (C2), D42.2 (C2), D48.2 (C2), D54.2 (C2), IC1.15 (O4)
unnamed: D13.2 (C2), D19.2 (C2), D25.2 (C2), D31.2 (C2), D37.2 (C2), D43.2 (C2), D49.2 (C2), D55.2 (C2), IC1.14 (O5)
unnamed: D14.2 (C2), D20.2 (C2), D26.2 (C2), D32.2 (C2), D38.2 (C2), D44.2 (C2), D50.2 (C2), D56.2 (C2), IC1.13 (O6)
unnamed: D15.3 (COM), U$2.P$2 (1B)
unnamed: D16.3 (COM), U$2.P$4 (2B)
unnamed: D17.3 (COM), U$2.P$6 (3B)
unnamed: D18.3 (COM), U$2.P$8 (4B)
unnamed: D19.3 (COM), U$2.P$10 (5B)
unnamed: D20.3 (COM), U$2.P$12 (6B)
unnamed: D28.3 (COM), U$4.P$4 (2B)
unnamed: D22.3 (COM), U$3.P$4 (2B)
unnamed: D23.3 (COM), U$3.P$6 (3B)
unnamed: D24.3 (COM), U$3.P$8 (4B)
unnamed: D25.3 (COM), U$3.P$10 (5B)
unnamed: D26.3 (COM), U$3.P$12 (6B)
unnamed: D45.3 (COM), U$7.P$2 (1B)
unnamed: D10.2 (C2), D16.2 (C2), D22.2 (C2), D28.2 (C2), D34.2 (C2), D40.2 (C2), D46.2 (C2), D52.2 (C2), IC1.17 (O2)
unnamed: D51.3 (COM), U$8.P$2 (1B)
unnamed: D1.3 (COM), U$1.P$1 (1A), U$1.P$3 (2A), U$1.P$5 (3A), U$1.P$7 (4A), U$1.P$9 (5A), U$1.P$11 (6A)
unnamed: D2.3 (COM), U$2.P$1 (1A), U$2.P$3 (2A), U$2.P$5 (3A), U$2.P$7 (4A), U$2.P$9 (5A), U$2.P$11 (6A)
unnamed: D29.3 (COM), U$4.P$6 (3B)
unnamed: D30.3 (COM), U$4.P$8 (4B)
unnamed: D3.2 (C2), IC4.16 (O3)
unnamed: D13.1 (A1), D19.1 (A1), D25.1 (A1), D31.1 (A1), D37.1 (A1), D43.1 (A1), D49.1 (A1), D55.1 (A1), Q1.14 (O5)
unnamed: D14.1 (A1), D20.1 (A1), D26.1 (A1), D32.1 (A1), D38.1 (A1), D44.1 (A1), D50.1 (A1), D56.1 (A1), Q1.13 (O6)
unnamed: D4.2 (C2), IC4.15 (O4)
unnamed: D5.2 (C2), IC4.14 (O5)
unnamed: D6.2 (C2), IC4.13 (O6)
unnamed: D7.2 (C2), IC4.12 (O7)
unnamed: D8.2 (C2), IC4.11 (O8)
unnamed: D31.3 (COM), U$4.P$10 (5B)
unnamed: D32.3 (COM), U$4.P$12 (6B)
unnamed: R1.1, R3.1, U2.1 (ADJ)
unnamed: D34.3 (COM), U$5.P$4 (2B)
unnamed: D35.3 (COM), U$5.P$6 (3B)
unnamed: D36.3 (COM), U$5.P$8 (4B)
unnamed: D37.3 (COM), U$5.P$10 (5B)
unnamed: D38.3 (COM), U$5.P$12 (6B)
unnamed: D40.3 (COM), U$6.P$4 (2B)
unnamed: D41.3 (COM), U$6.P$6 (3B)
unnamed: D42.3 (COM), U$6.P$8 (4B)
unnamed: D43.3 (COM), U$6.P$10 (5B)
unnamed: D44.3 (COM), U$6.P$12 (6B)
unnamed: D46.3 (COM), U$7.P$4 (2B)
unnamed: D47.3 (COM), U$7.P$6 (3B)
unnamed: D48.3 (COM), U$7.P$8 (4B)
unnamed: D49.3 (COM), U$7.P$10 (5B)
unnamed: D50.3 (COM), U$7.P$12 (6B)
unnamed: D52.3 (COM), U$8.P$4 (2B)
unnamed: D53.3 (COM), U$8.P$6 (3B)
unnamed: D54.3 (COM), U$8.P$8 (4B)
unnamed: D55.3 (COM), U$8.P$10 (5B)
unnamed: D56.3 (COM), U$8.P$12 (6B)
unnamed: D9.1 (A1), D15.1 (A1), D21.1 (A1), D27.1 (A1), D33.1 (A1), D39.1 (A1), D45.1 (A1), D51.1 (A1), Q1.18 (O1)
PIN_0: IC2.1 (A0), IC3.1 (A0), U$9.D9
PIN_1: IC2.2 (A1), IC3.2 (A1), U$9.D10
PIN_2: IC2.3 (A2), IC3.3 (A2), U$9.D11
RAW: C5.1, J1.PWR, U2.3 (IN), U$9.RAW
RESET: IC2.6 (E3), IC3.4 (!E1), IC5.4 (!E1), IC6.6 (E3), U$9.D4
SET: IC2.4 (!E1), IC3.6 (E3), IC5.6 (E3), IC6.4 (!E1), U$9.D5
VCC: C1.2, C2.2, C3.2, C4.2, IC2.16 (VCC), IC3.16 (VCC), IC5.16 (VCC), IC6.16 (VCC), J3.2, U$9.5V (5.5V)
V_DRIVE: C6.1, IC1.10 (CMN), IC4.10 (CMN), J2.2, J3.1, Q1.9 (VCC), Q2.9 (VCC), R3.2, U2.2 (OUT)

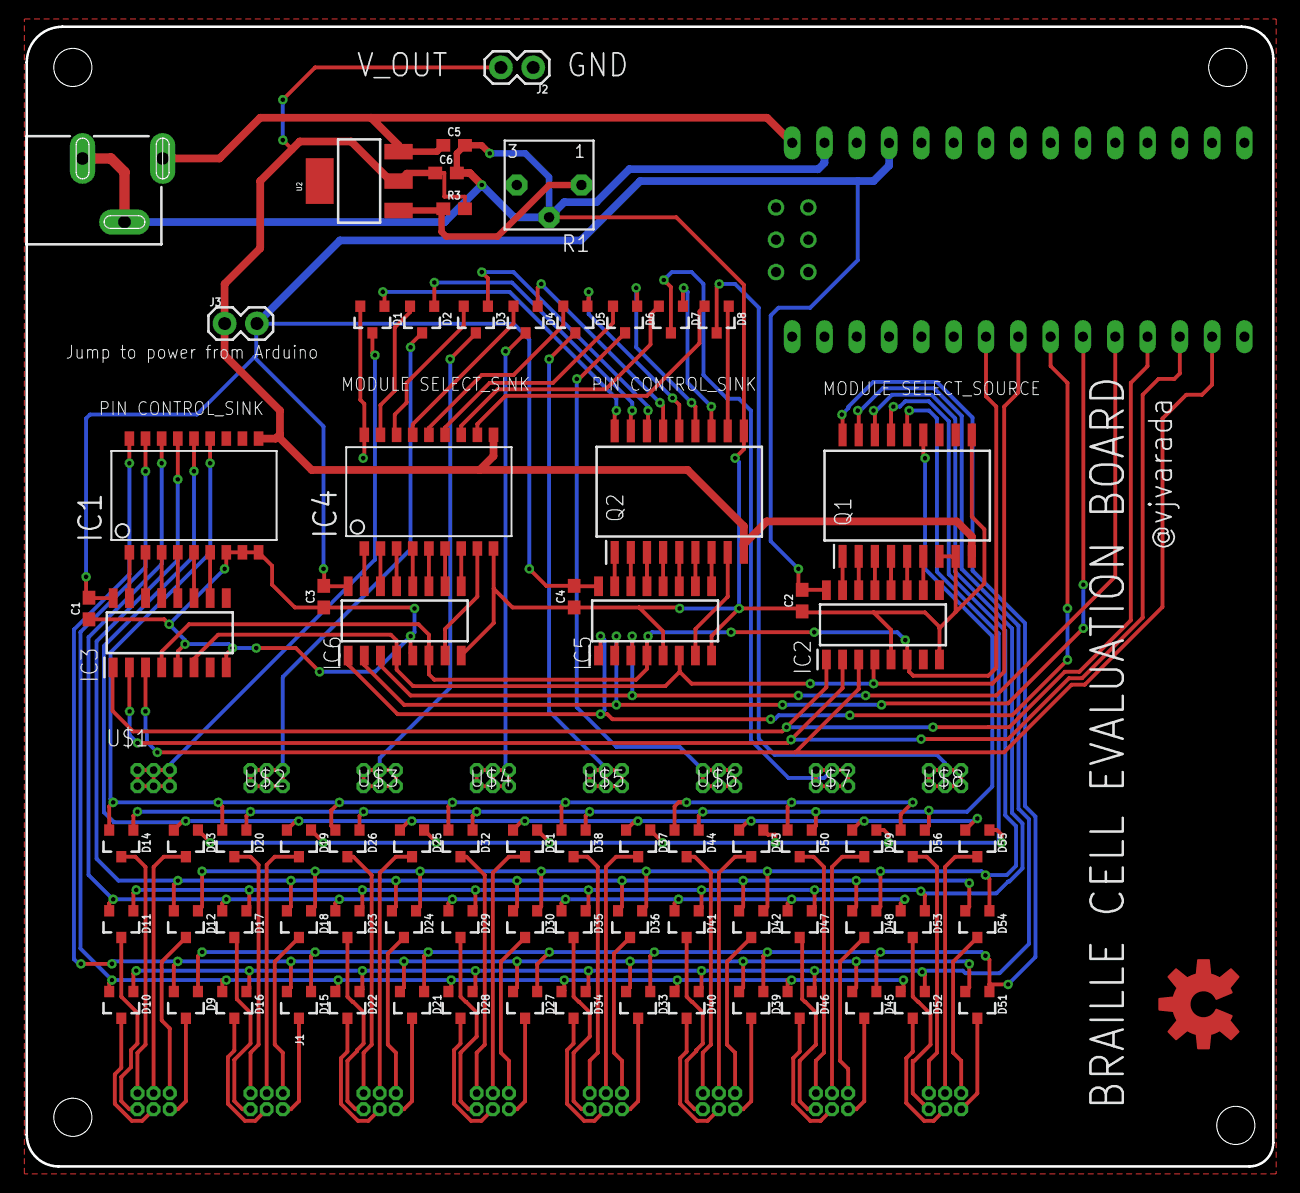
[picture p16: board Braille Evaluation Board.brd from above]

Board: 2 copper layers, 98.0 x 89.6 mm, 86 parts (0 on the bottom side), 125 nets.
