phutruonnttn/braille-setup/(commit log)

2026-10-13 Fix Braille PCB routing for Vietnam DFM rules
2026-10-13 Re-export large PCB for Vietnam factory rules
